lhr-solar/Active-Precharge-Board/SOT-89-3_2P7X4P7_ONS.step

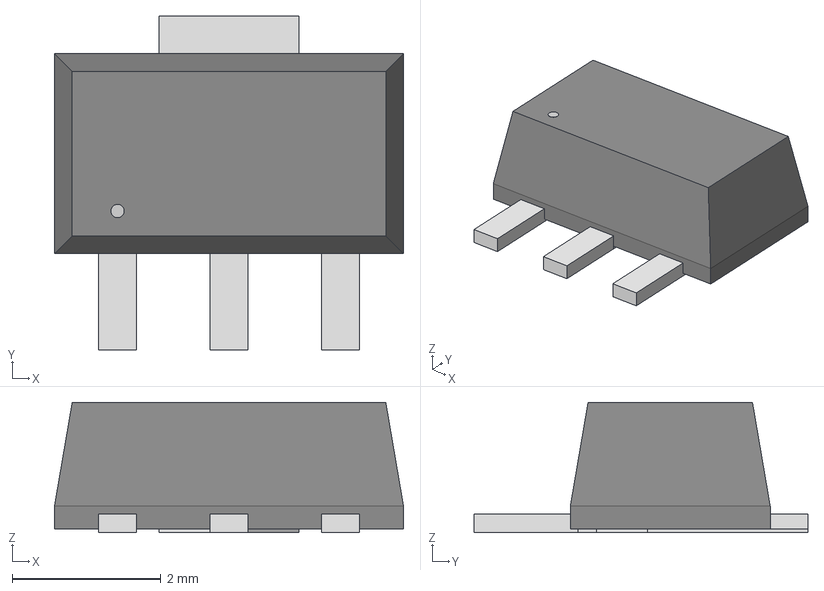
[picture p1: CAD file, 2024-10-26]
SOT-89-3_2P7X4P7_ONS.step
4.70 x 4.50 x 1.75 mm
