lhr-solar/Active-Precharge-Board/ActivePrechargeLib/ActivePrechargeLib3d/BZT52-B12-QX.stp

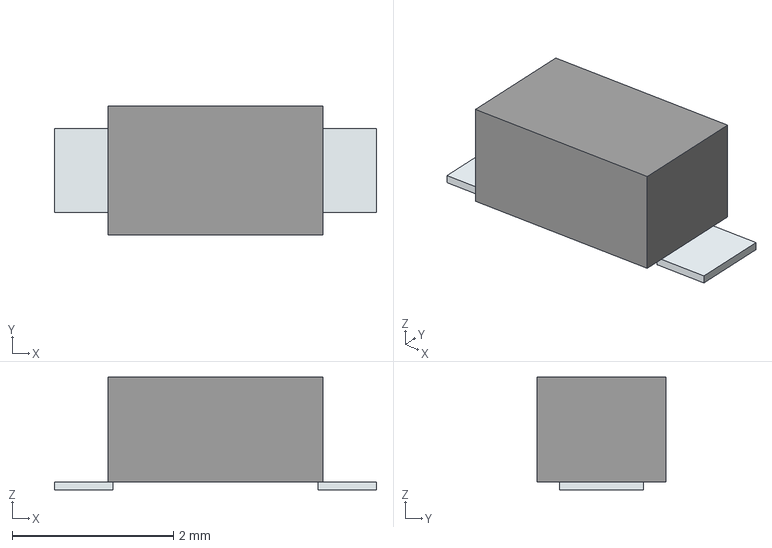
[picture p2: CAD file, 2025-01-31]
ActivePrechargeLib/ActivePrechargeLib3d/BZT52-B12-QX.stp
4.00 x 1.60 x 1.40 mm
Pins
