lhr-solar/Active-Precharge-Board/ActivePrechargeLib/ActivePrechargeLib3d/SSM3J374R,LF.stp

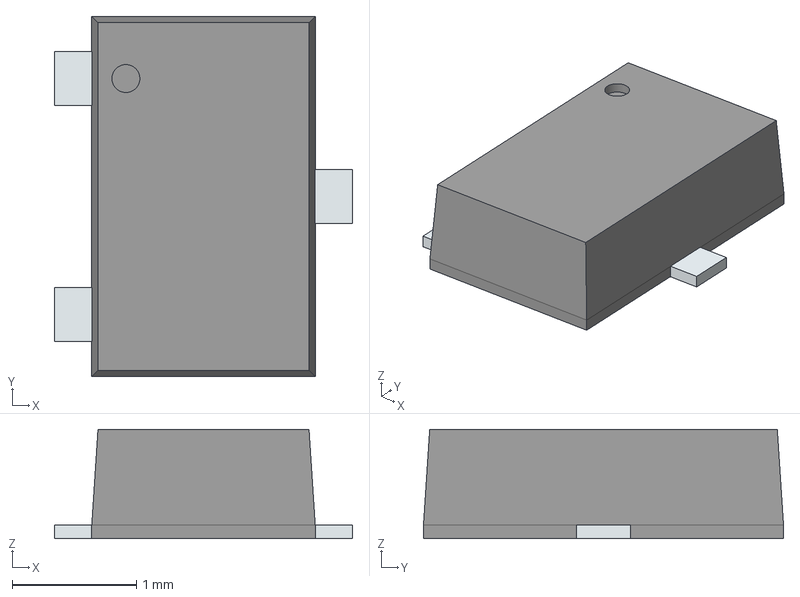
[picture p3: CAD file, 2025-01-31]
ActivePrechargeLib/ActivePrechargeLib3d/SSM3J374R,LF.stp
2.40 x 2.90 x 0.878 mm
PinsArrayL
PinsArrayR
