lhr-solar/Active-Precharge-Board/ActivePrechargeLib/ActivePrechargeLib3d/CMS08_TE12L,Q,M_.stp

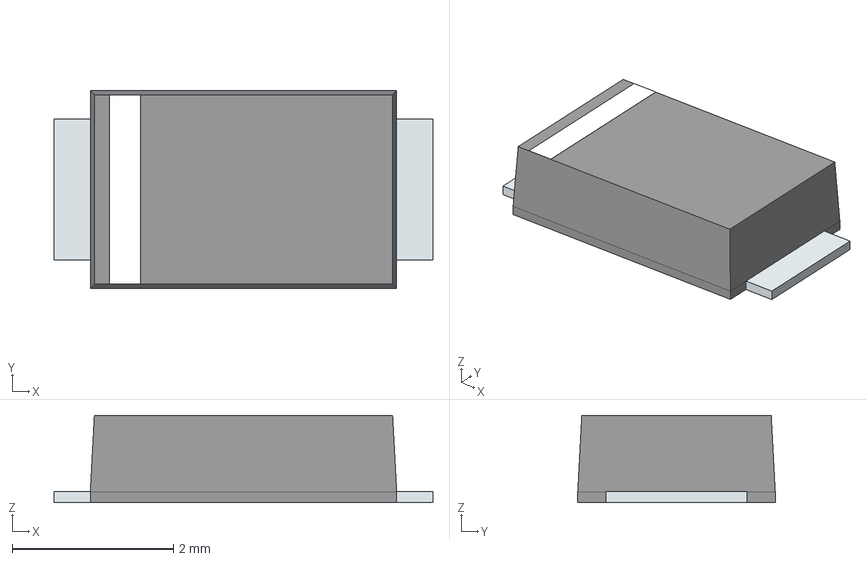
[picture p4: CAD file, 2024-10-30]
ActivePrechargeLib/ActivePrechargeLib3d/CMS08_TE12L,Q,M_.stp
4.70 x 2.45 x 1.08 mm
PinKIdent
PinK
PinA
