lhr-solar/Active-Precharge-Board/ActivePrechargeLib/ActivePrechargeLib3d/430450613.stp

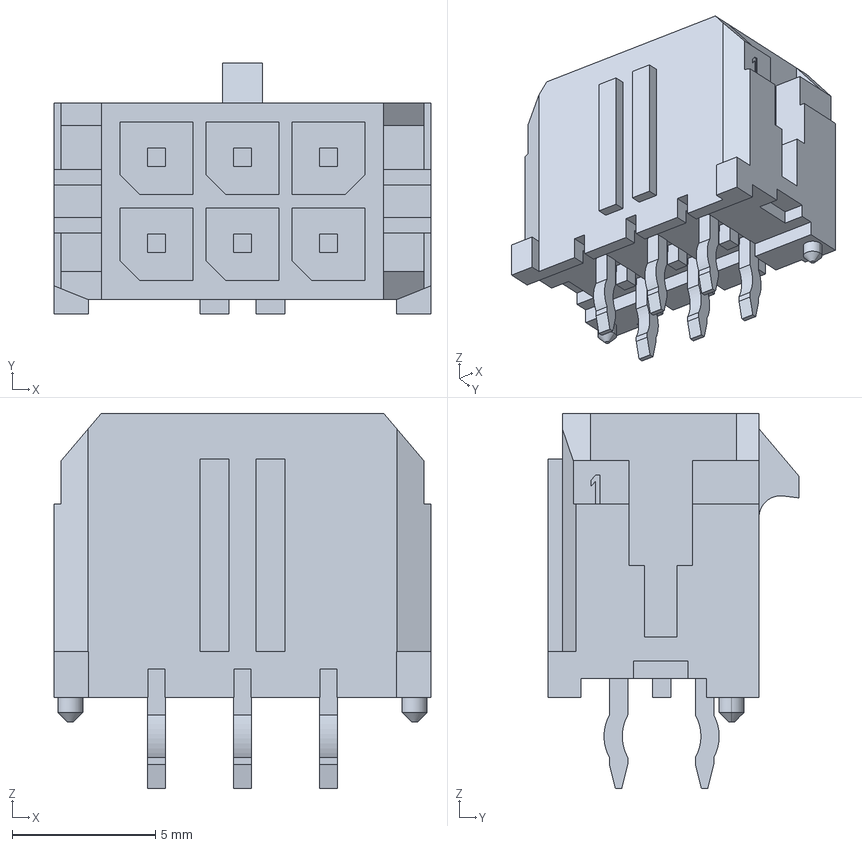
[picture p5: CAD file, 2025-01-31]
ActivePrechargeLib/ActivePrechargeLib3d/430450613.stp
13.2 x 8.77 x 13.1 mm
