lhr-solar/Active-Precharge-Board/ActivePrechargeLib/ActivePrechargeLib3d/1769205241.stp

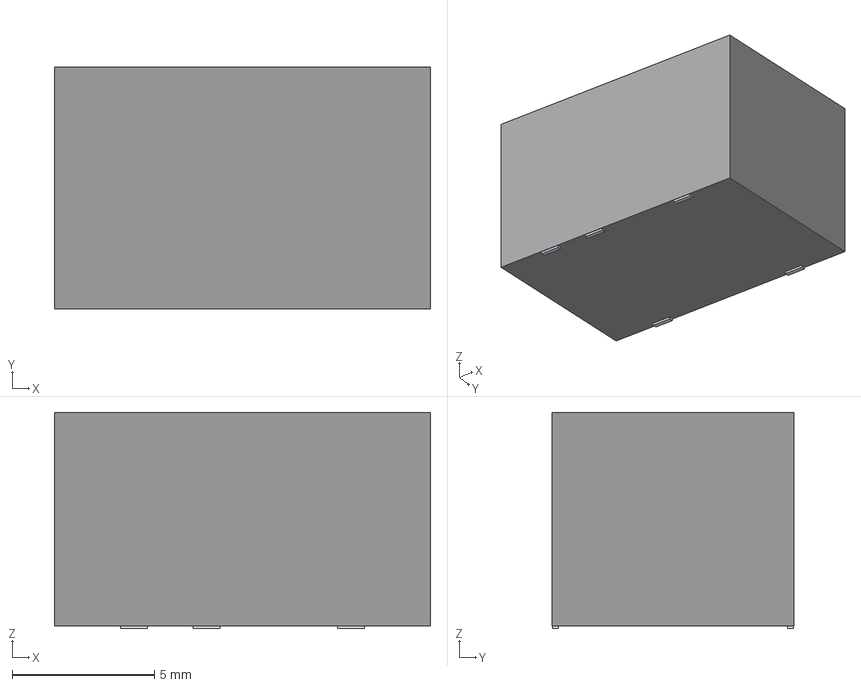
[picture p6: CAD file, 2025-01-31]
ActivePrechargeLib/ActivePrechargeLib3d/1769205241.stp
13.2 x 8.50 x 7.60 mm
Pins
