lhr-solar/Active-Precharge-Board/ActivePrechargeLib/ActivePrechargeLib3d/436500315.stp

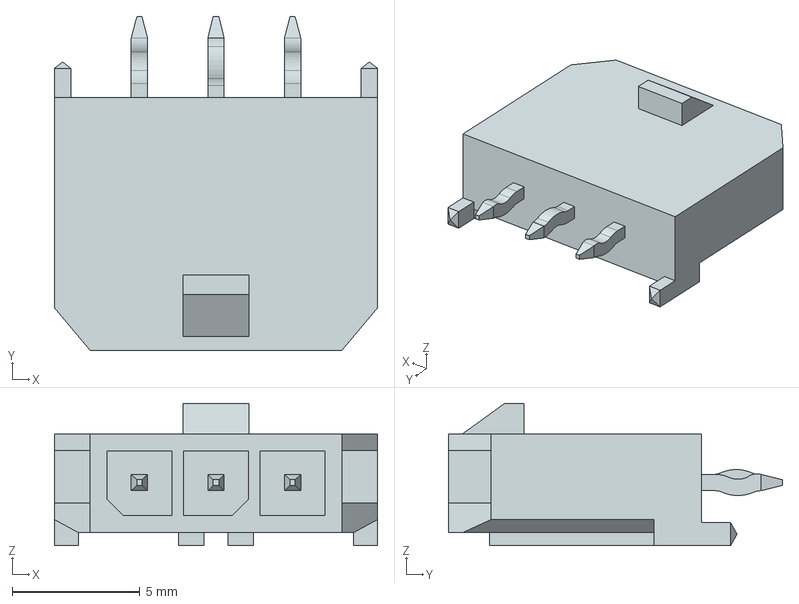
[picture p7: CAD file, 2025-01-31]
ActivePrechargeLib/ActivePrechargeLib3d/436500315.stp
12.7 x 13.1 x 5.57 mm
