lhr-solar/Active-Precharge-Board/ActivePrechargeLib/ActivePrechargeLib3d/46205000000.stp

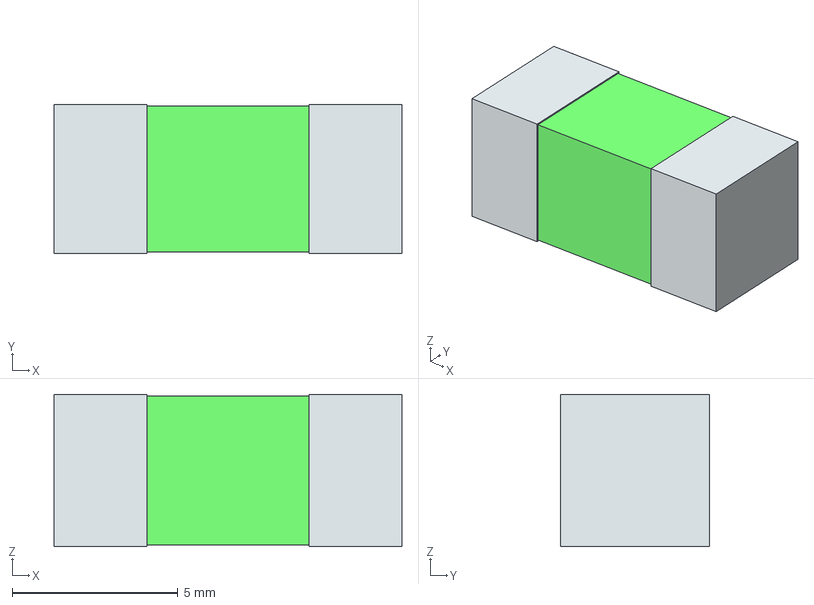
[picture p8: CAD file, 2024-10-26]
ActivePrechargeLib/ActivePrechargeLib3d/46205000000.stp
10.5 x 4.50 x 4.60 mm
term1
term2
