lhr-solar/Active-Precharge-Board/ActivePrechargeLib/ActivePrechargeLib3d/2220B225K251CT.stp

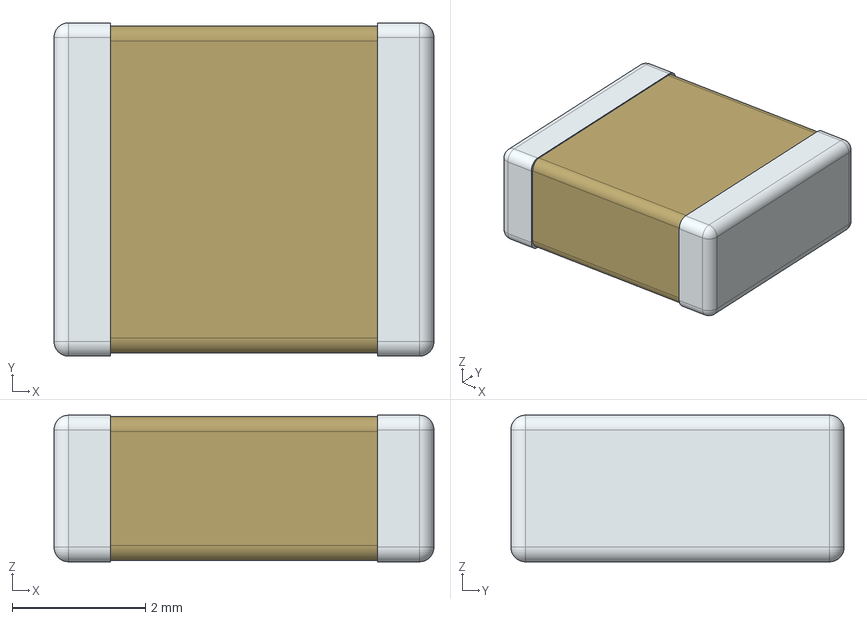
[picture p9: CAD file, 2024-10-26]
ActivePrechargeLib/ActivePrechargeLib3d/2220B225K251CT.stp
5.70 x 5.00 x 2.20 mm
