lhr-solar/Active-Precharge-Board/(list of files, cad)

Other CAD files:
ActivePrechargeLib/ActivePrechargeLib3d/SOT-89-3_2P7X4P7_ONS.step
