lhr-solar/Active-Precharge-Board/ActivePrecharge.kicad_pcb

## KiCad design ActivePrecharge.kicad_pcb (2025-01-31)

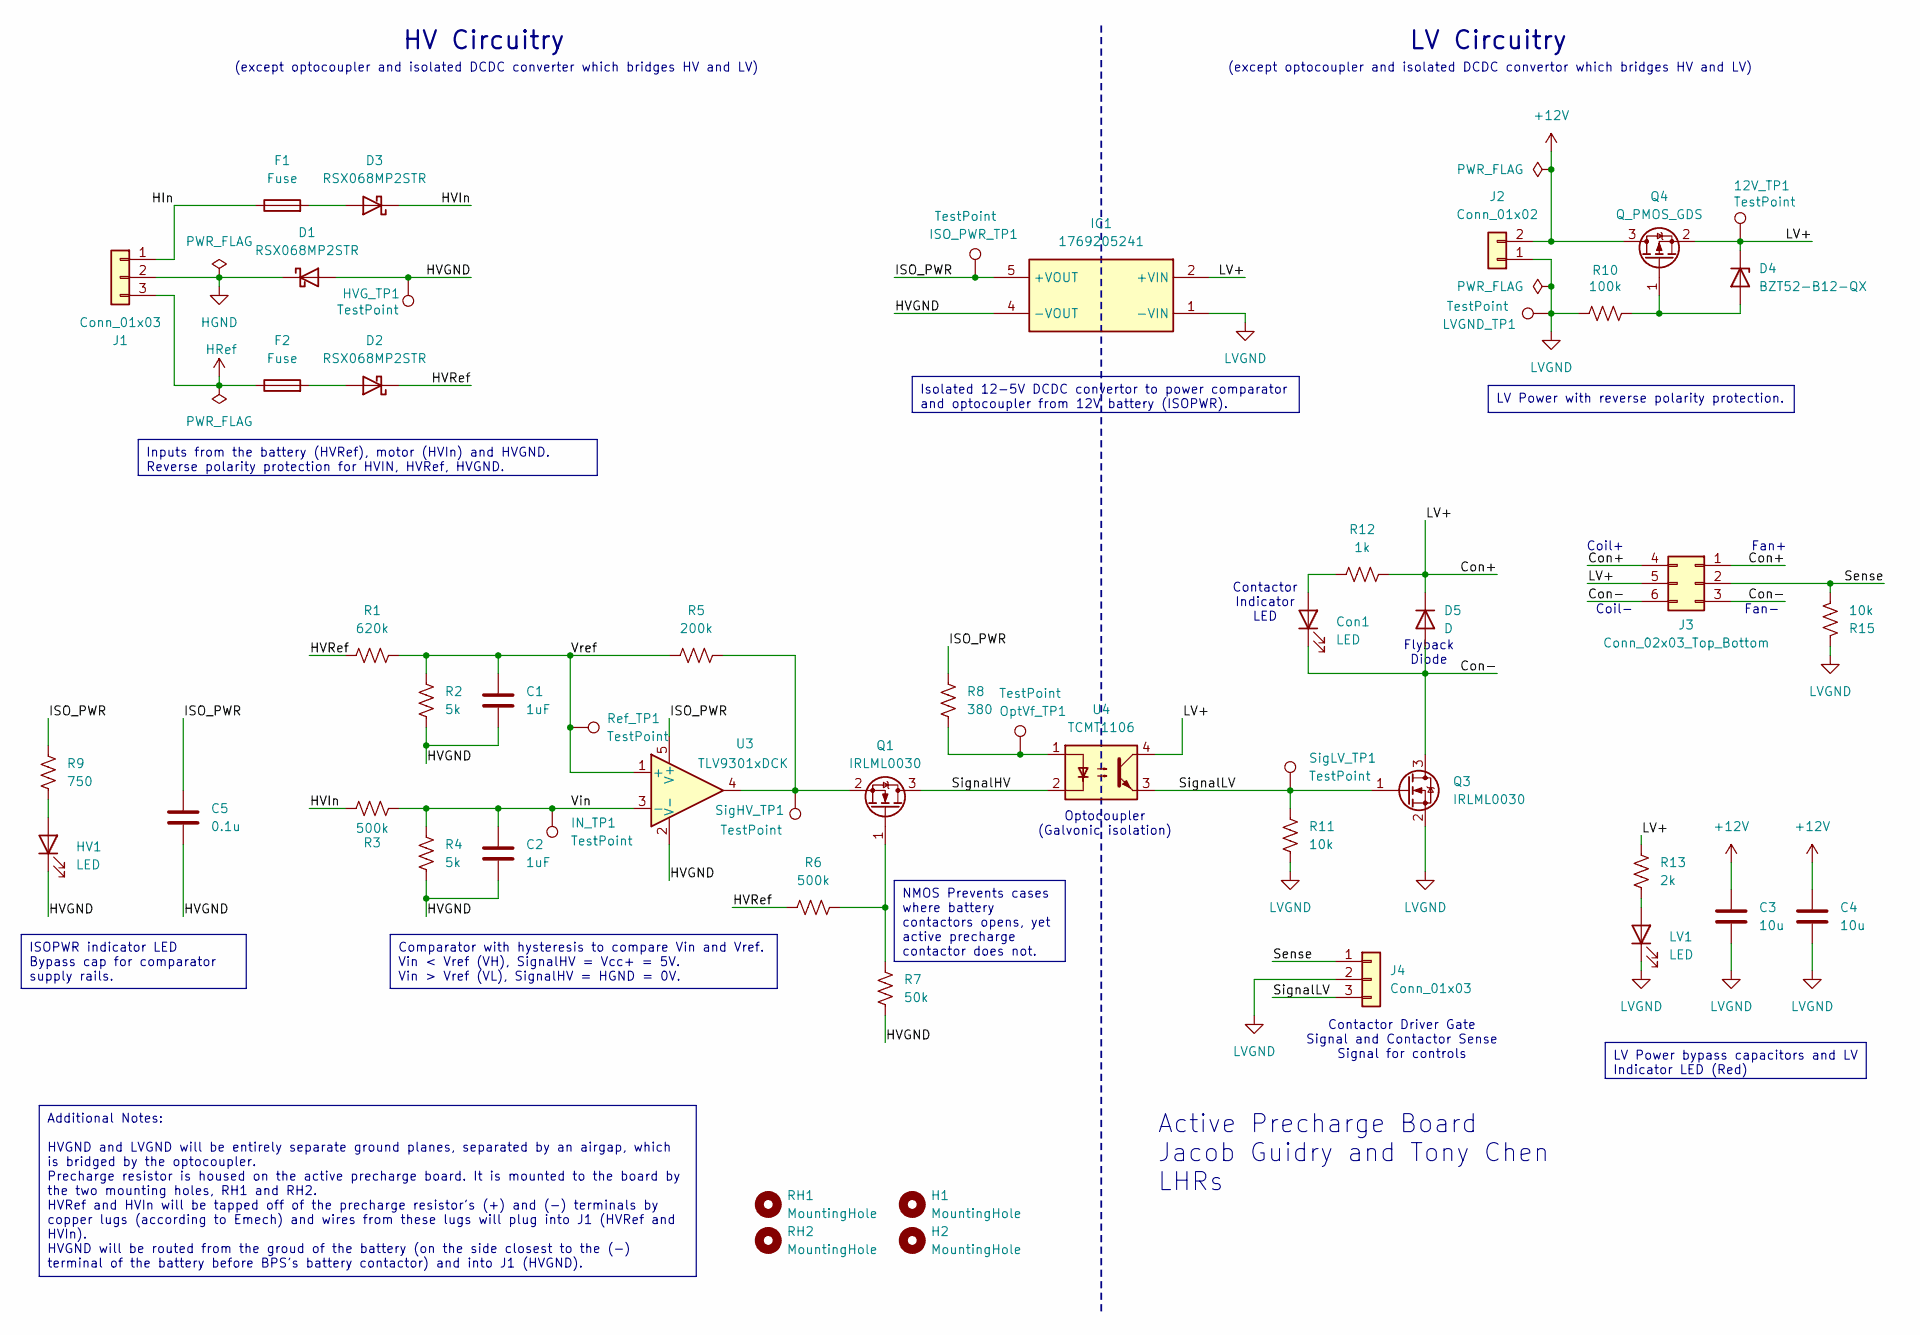
[picture p10: schematic ActivePrecharge.kicad_sch]

Parts:
12V_TP1: TestPoint; TestPoint_HEX_3mmID
C1, C2: 1uF; C_0805_2012Metric
C3, C4: 10u; C_0805_2012Metric
C5: 0.1u; C_0805_2012Metric
Con1: LED; LED_0805_2012Metric
D1, D2, D3: RSX068MP2STR; D_SOD-123F
D4: BZT52-B12-QX; BZT52B12QX
D5: D; SODFL4724X108N
F1, F2: Fuse; Fuseholder_Blade_Mini_Keystone_3568
H1, H2: MountingHole; MountingHole_3mm
HV1: LED; LED_0805_2012Metric
HVG_TP1: TestPoint; TestPoint_HEX_3mmID
IC1: 1769205241; Manufacturer_Part_Number 1769205241
IN_TP1: TestPoint; TestPoint_HEX_3mmID
ISO_PWR_TP1: TestPoint; TestPoint_HEX_3mmID
J1, J4: Conn_01x03; Molex_MicroFit3.0_1x3xP3.00mm_PolarizingPeg_Vertical
J2: Conn_01x02; Molex_MicroFit3.0_1x2xP3.00mm_PolarizingPeg_Vertical
J3: Conn_02x03_Top_Bottom; CONN_SD-43045-005_06_MOL
LV1: LED; LED_0805_2012Metric
LVGND_TP1: TestPoint; TestPoint_HEX_3mmID
OptVf_TP1: TestPoint; TestPoint_HEX_3mmID
Q1, Q3: IRLML0030; SOT-23
Q4: Q_PMOS_GDS; SOT-23-3
R1: 620k; R_1206_3216Metric
R2, R4: 5k; R_0805_2012Metric
R3, R6: 500k; R_1206_3216Metric
R5: 200k; R_0805_2012Metric
R7: 50k; R_0805_2012Metric
R8: 380; R_0805_2012Metric
R9: 750; R_0805_2012Metric
R10: 100k; R_0805_2012Metric
R11, R15: 10k; R_0805_2012Metric
R12: 1k; R_0805_2012Metric
R13: 2k; R_0805_2012Metric
RH1, RH2: MountingHole; MountingHole_3.2mm_M3
Ref_TP1: TestPoint; TestPoint_HEX_3mmID
SigHV_TP1: TestPoint; TestPoint_HEX_3mmID
SigLV_TP1: TestPoint; TestPoint_HEX_3mmID
U3: TLV9301xDCK; SOT-353_SC-70-5
U4: TCMT1106; SOP-4_4.4x2.6mm_P1.27mm

Connections:
+12V: C3.1, C4.1, J2.2, Q4.3 (S)
/Con+: 12V_TP1.1, D4.1 (K), D5.1 (K), IC1.2 (+VIN), J3.1, J3.4, J3.5, Q4.2 (D), R12.2, R13.1, U4.4
/Con-: Con1.1 (K), D5.2 (A), J3.3, J3.6, Q3.3 (D)
/HIn: F1.1, J1.1
/HVGND: C1.2, C2.2, C5.2, D1.2 (A), HV1.1 (K), HVG_TP1.1, IC1.4 (-VOUT), R2.2, R4.2, R7.1, U3.2 (V-)
/HVIn: D3.1 (K), R3.2
/HVRef: D2.1 (K), R1.1, R6.1
/ISO_PWR: C5.1, IC1.5 (+VOUT), ISO_PWR_TP1.1, R8.2, R9.1, U3.5 (V+)
/Sense: J3.2, J4.1, R15.2
/SignalHV: Q1.3 (D), U4.2
/SignalLV: J4.3, Q3.1 (G), R11.1, SigLV_TP1.1, U4.3
/Vin: C2.1, IN_TP1.1, R3.1, R4.1, U3.3 (-)
/Vref: C1.1, R1.2, R2.1, R5.2, Ref_TP1.1, U3.1 (+)
HGND: D1.1 (K), J1.2
HRef: F2.1, J1.3
LVGND: C3.2, C4.2, IC1.1 (-VIN), J2.1, J4.2, LV1.1 (K), LVGND_TP1.1, Q3.2 (S), R10.1, R11.2, R15.1
unnamed: Con1.2 (A), R12.1
unnamed: D2.2 (A), F2.2
unnamed: D3.2 (A), F1.2
unnamed: D4.2 (A), Q4.1 (G), R10.2
unnamed: HV1.2 (A), R9.2
unnamed: LV1.2 (A), R13.2
unnamed: OptVf_TP1.1, R8.1, U4.1
unnamed: Q1.1 (G), R6.2, R7.2
unnamed: Q1.2 (S), R5.1, SigHV_TP1.1, U3.4

Notes on the sheet:
ISOPWR indicator LED Bypass cap for comparator supply rails.
NMOS Prevents cases where battery contactors opens, yet active precharge contactor does not.
Inputs from the battery (HVRef), motor (HVIn) and HVGND. Reverse polarity protection for HVIN, HVRef, HVGND.
Comparator with hysteresis to compare Vin and Vref. Vin < Vref (VH), SignalHV = Vcc+ = 5V. Vin > Vref (VL), SignalHV = HGND = 0V.
LV Power with reverse polarity protection.
LV Power bypass capacitors and LV Indicator LED (Red)
Additional Notes: HVGND and LVGND will be entirely separate ground planes, separated by an airgap, which is bridged by the optocoupler. Precharge resistor is housed on the active precharge board. It is mounted to the board by the two mounting holes, RH1 and RH2. HVRef and HVIn will be tapped off of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
Isolated 12-5V DCDC convertor to power comparator and optocoupler from 12V battery (ISOPWR).
Coil+
Contactor Driver Gate Signal and Contactor Sense Signal for controls
LV Circuitry
Fan+
Flyback Diode
HV Circuitry
Optocoupler (Galvonic isolation)
(except optocoupler and isolated DCDC converter which bridges HV and LV)
Coil-
Contactor Indicator LED
Fan-
(except optocoupler and isolated DCDC convertor which bridges HV and LV)
Active Precharge Board Jacob Guidry and Tony Chen LHRs

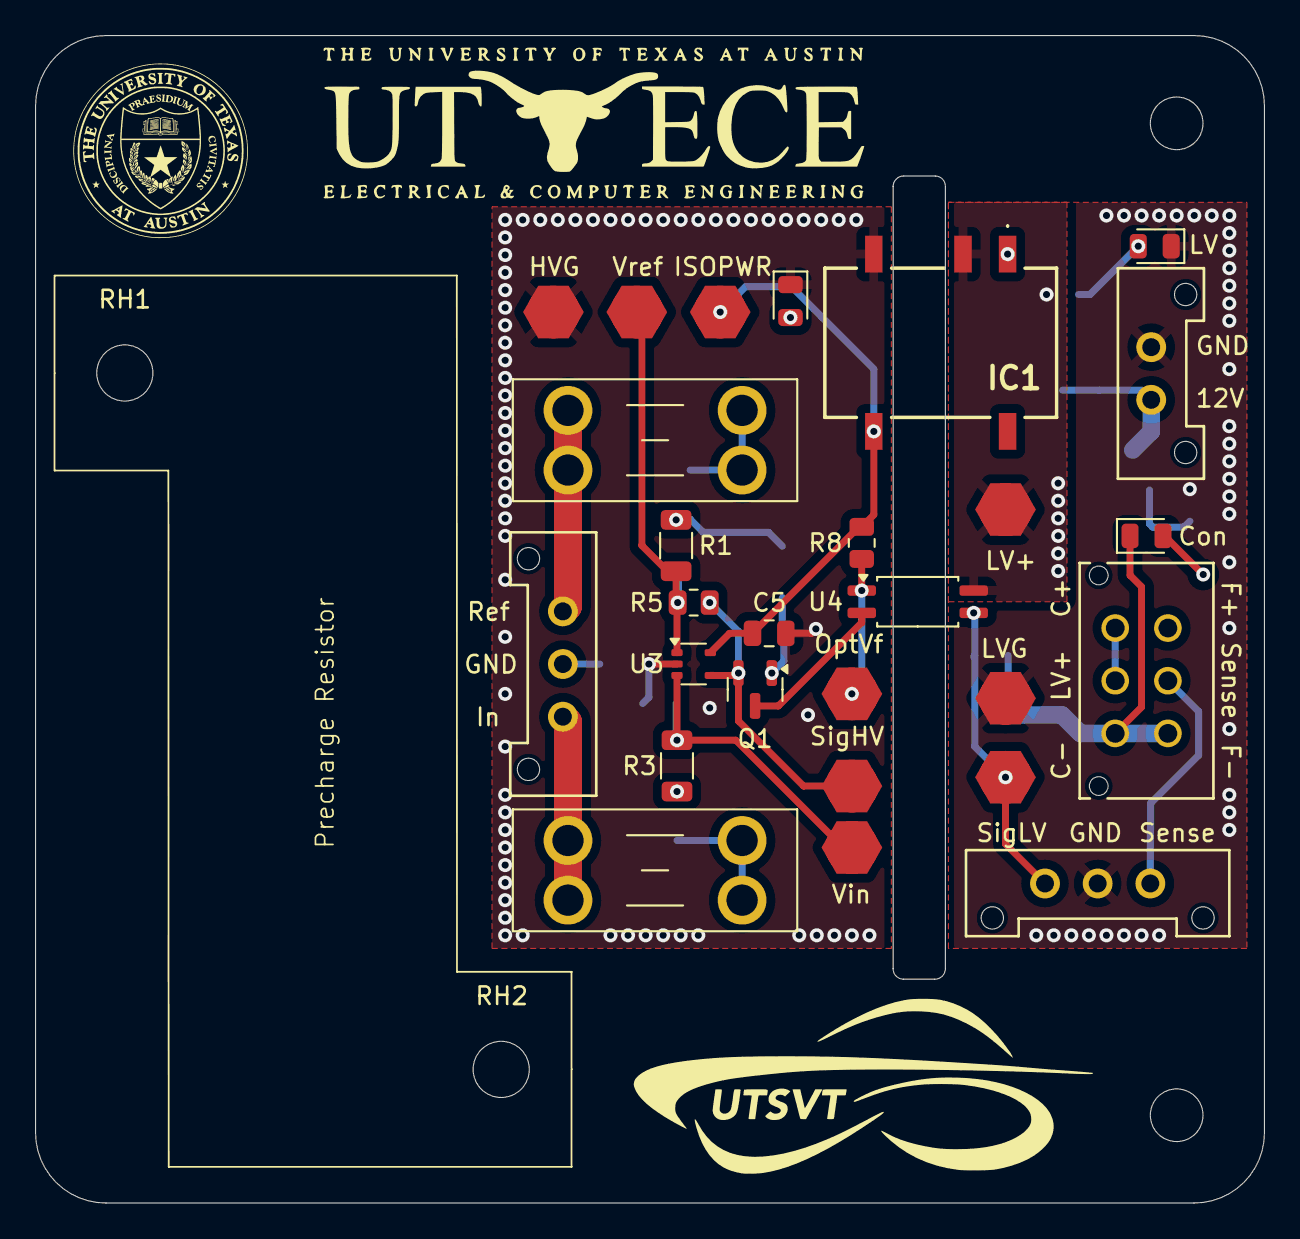
[picture p11: board ActivePrecharge.kicad_pcb from above]

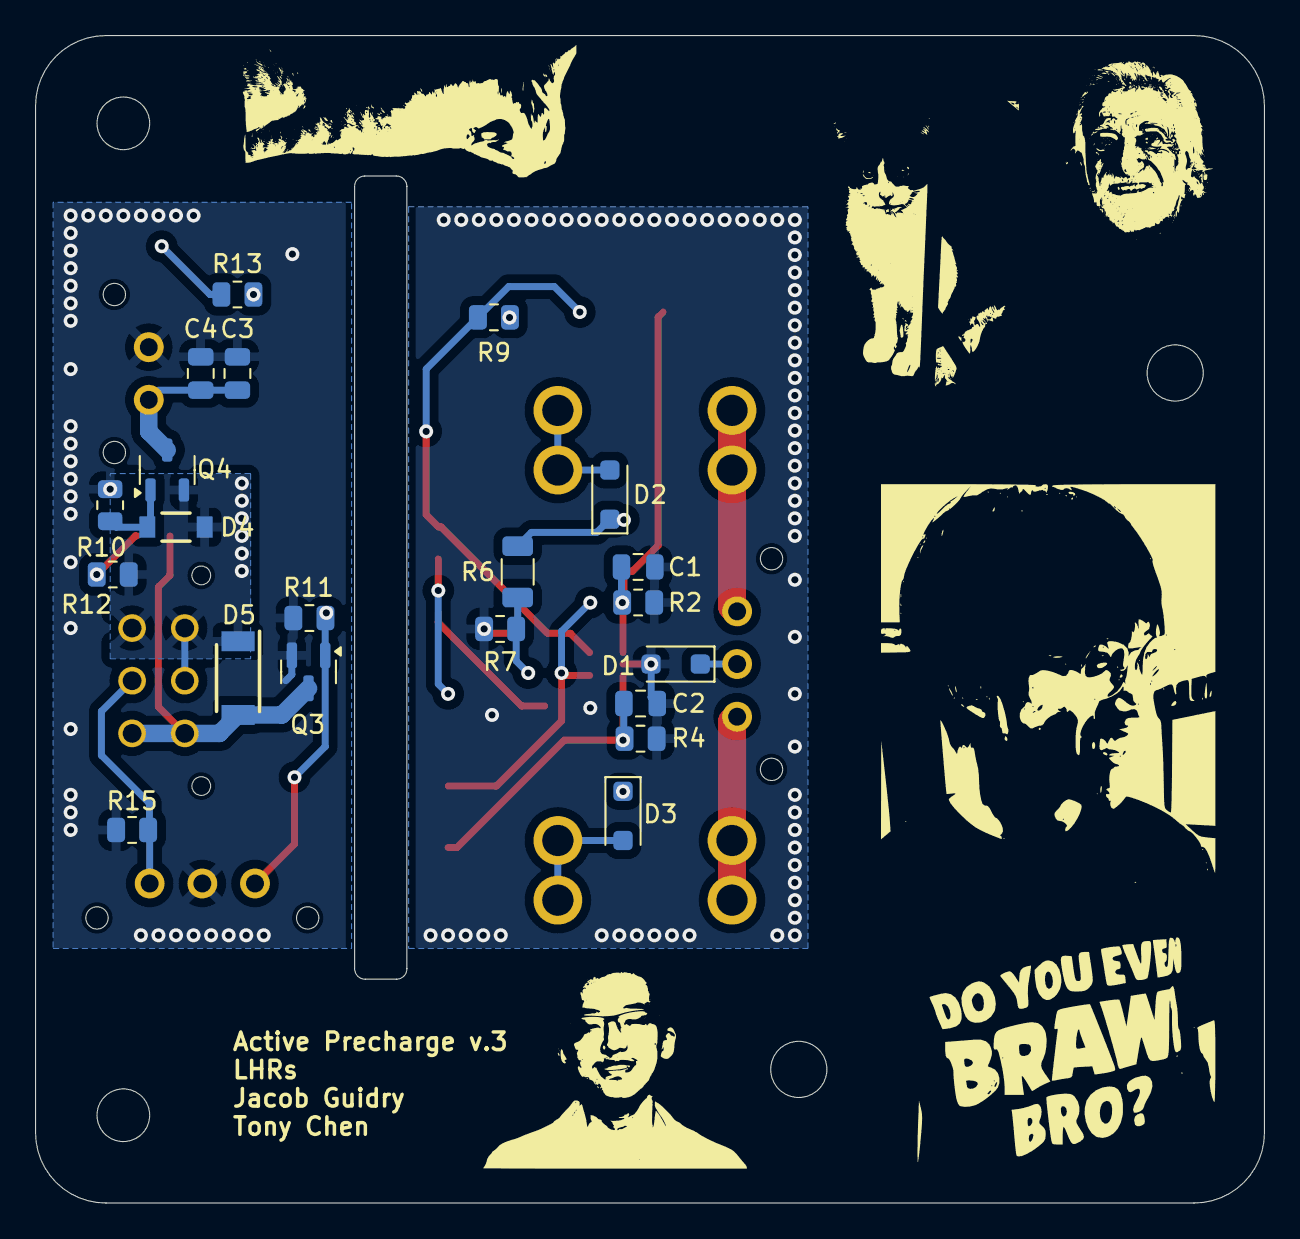
[picture p12: board ActivePrecharge.kicad_pcb from below]

Board: 2 copper layers, 70.0 x 66.5 mm, 52 parts (21 on the bottom side), 25 nets.
