lhr-solar/Active-Precharge-Board/Firmware/Drivers/Inc/StatusLEDs.h

#ifndef STATUSLEDS_H
#define STATUSLEDS_H

#include "stm32xx_hal.h"

/**
 * Possible Status LED Pins
 */
typedef enum {
    MOTOR_SENSE_FAULT_LED = 0,
    MOTOR_TIMEOUT_FAULT_LED,
    ARRAY_SENSE_FAULT_LED,
    ARRAY_TIMEOUT_FAULT_LED,
    ONBOARD_LED,
    NUM_STATUS_LED,
} status_led_t;

// Status LEDs
#define MOTOR_TIMEOUT_FAULT_LED_PORT GPIOA
#define MOTOR_TIMEOUT_FAULT_LED_PIN GPIO_PIN_10

#define MOTOR_SENSE_FAULT_LED_PORT GPIOA
#define MOTOR_SENSE_FAULT_LED_PIN GPIO_PIN_8

#define ARRAY_TIMEOUT_FAULT_LED_PORT GPIOB
#define ARRAY_TIMEOUT_FAULT_LED_PIN GPIO_PIN_3

#define ARRAY_SENSE_FAULT_LED_PORT GPIOA
#define ARRAY_SENSE_FAULT_LED_PIN GPIO_PIN_9

#define ONBOARD_LED_PORT GPIOB
#define ONBOARD_LED_PIN GPIO_PIN_3

/**
* @brief Initializes Status LED pins
*
*/
void Status_Leds_Init(void);

/**
 * @brief   Writes data to a specified pin
 * @param   led The led to write to
 * @param   state true=ON or false=OFF
 * @return  None
 */
void Status_Leds_Write(status_led_t led, bool state);

/**
 * @brief   Toggles a status led
 * @param   led The led to toggle
 * @return  None
 */
void Status_Leds_Toggle(status_led_t led);

/**
 * @brief   Turns all status LEDs on
 * @return  None
 */
void Status_Leds_All_On(void);

#endif
