lhr-solar/Active-Precharge-Board/(commit log)

2024-10-19 add kicadlibraries
2024-10-19 Jacob ActivePrecharge footprints completed and layout started
    [ActivePrecharge.kicad_pcb, ActivePrecharge.kicad_sch]
2024-10-26 end of workday 10/26/2024
    [ActivePrecharge.kicad_pcb, ActivePrecharge.kicad_sch]
2024-10-26 with new component footprints and cad files
    [2220B225K251CT.SchLib, 2220B225K251CT.stp, 46205000000.stp, CAPC5750X220N.PcbLib, EDI2CAP.CFG, SOT-89-3_2P7X4P7_ONS.step, capc5750x220n.psm, chips.prt]
2024-10-30 sch ready for review, project specific footprint and 3d model libraries created
    [2220B225K251CT.SchLib, 2220B225K251CT.stp, 46205000000.stp, ActivePrecharge.kicad_pcb, ActivePrecharge.kicad_sch, CAPC5750X220N.PcbLib, CMS08_TE12L,Q,M_.stp, EDI2CAP.CFG]
2024-10-31 selected LV bypass caps values
    [ActivePrecharge.kicad_pcb, ActivePrecharge.kicad_sch]
2024-10-31 finalized layout, fixed prechagre res dimensions
    [ActivePrecharge.kicad_pcb, ActivePrecharge.kicad_sch]
2024-11-01 removed LDO fuse, added series resistors, added to sch explinations, changed layout accordingly, sch and layout ready for review
    [ActivePrecharge.kicad_sch]
2024-11-01 oops forgot to save last time, attempt two
    [ActivePrecharge.kicad_pcb, ActivePrecharge.kicad_sch]
2024-11-02 added silkscreen title
    [ActivePrecharge.kicad_pcb]
2024-11-02 passes ERC now, added dimensions on layout editor
    [ActivePrecharge.kicad_pcb, ActivePrecharge.kicad_sch]
2024-11-02 fixed optocoupler data sheet link
    [ActivePrecharge.kicad_sch]
2024-11-02 added connector labels
    [ActivePrecharge.kicad_pcb]
2024-11-02 11/2 fixed incorrect footprint and symbol
    [ActivePrecharge.kicad_pcb, ActivePrecharge.kicad_sch]
2024-11-02 HV and trace routing fixes
    [ActivePrecharge.kicad_pcb]
2024-11-02 dimension checks and silkscreen additions
    [ActivePrecharge.kicad_pcb]
2024-11-02 revert LDO HV resistor position
    [ActivePrecharge.kicad_pcb]
2024-11-02 adjusted HVGND position to be more centralized, added backplane traces and vias to route HVGND up to somewhat isolated top region, routed R1, R3 top plane traces on the back
    [ActivePrecharge.kicad_pcb, ActivePrecharge.kicad_sch]
2024-11-02 refix HVGND isolation issue
    [ActivePrecharge.kicad_pcb]
2024-11-02 fixed positioning of silkscreen labels for HV 1x3 connector
    [ActivePrecharge.kicad_pcb]
2024-11-02 fixed silkscreen and edge cuts issues
    [ActivePrecharge.kicad_pcb]
2024-11-06 initial sch and layout changes w/ test points
    [ActivePrecharge.kicad_pcb, ActivePrecharge.kicad_sch]
2024-11-06 finished layout w/ all testpoints
    [ActivePrecharge.kicad_pcb]
2024-11-06 improved tp labels, moved vias on the tp rather than next to the tp, removed ConIndVf and LVIndVf tp (pointless)
    [ActivePrecharge.kicad_pcb, ActivePrecharge.kicad_sch]
2024-11-10 redid sch and layout w/ reverse polarity protection on HV and LV inputs, low pass filter on comparator inputs, hystersesis on comparator
    [ActivePrecharge.kicad_pcb, ActivePrecharge.kicad_sch, BZT52-B12-QX.stp, untitled.kicad_sch]
2024-11-10 try 2
    [ActivePrecharge.kicad_pcb]
2024-11-10 updated sch explinations with new additions from today's workday
    [ActivePrecharge.kicad_sch]
2024-11-10 fixed pmos orientation on LV reverse polarity protection, was s and d were backwards
    [ActivePrecharge.kicad_pcb, ActivePrecharge.kicad_sch]
2024-11-11 HV Layout w/ components on the back
    [ActivePrecharge.kicad_pcb, ActivePrecharge.kicad_sch]
2024-11-13 components places on both sides of the board for HV and LV sides, ready for review
    [ActivePrecharge.kicad_pcb, ActivePrecharge.kicad_sch]
2024-11-16 sch done for workday 11/16/2024
    [1769205241.stp, ActivePrecharge.kicad_pcb, ActivePrecharge.kicad_sch, SSM3J374R,LF.stp]
2024-11-19 layout and sch ready for review (isolated DCDC convertor version)
    [ActivePrecharge.kicad_pcb, ActivePrecharge.kicad_sch]
2024-11-19 added silkscreen labels to HV 1x3 connector
    [436500315.stp, ActivePrecharge.kicad_pcb]
2024-11-23 finished for review
    [ActivePrecharge.kicad_pcb, ActivePrecharge.kicad_sch]
2024-11-23 fixed incorrect pmos pinout
    [ActivePrecharge.kicad_pcb, ActivePrecharge.kicad_sch]
2024-12-06 pretty sch changxu approved
    [ActivePrecharge-B_Cu.gbl, ActivePrecharge-B_Mask.gbs, ActivePrecharge-B_Paste.gbp, ActivePrecharge-B_Silkscreen.gbo, ActivePrecharge-Edge_Cuts.gm1, ActivePrecharge-F_Cu.gtl, ActivePrecharge-F_Mask.gts, ActivePrecharge-F_Paste.gtp]
2024-12-14 started hv layout rework w/ fuses, changed lv layout connectors
    [ActivePrecharge.kicad_pcb, ActivePrecharge.kicad_sch]
2024-12-26 all layout and sch changes finished, ready for frank to review
    [430450613.stp, ActivePrecharge.kicad_pcb, ActivePrecharge.kicad_sch]
2024-12-29 pushing new changes 12/29
    [ActivePrecharge.kicad_pcb]
2024-12-31 ready for order from jlc
    [ActivePrecharge.kicad_pcb]
2024-12-31 oops didnt save
    [ActivePrecharge.kicad_pcb]
2025-01-06 v.3 ordered, fixed lv reverse polarity pmos body diode
    [ActivePrecharge-B_Cu.gbl, ActivePrecharge-B_Mask.gbs, ActivePrecharge-B_Paste.gbp, ActivePrecharge-B_Silkscreen.gbo, ActivePrecharge-Edge_Cuts.gm1, ActivePrecharge-F_Cu.gtl, ActivePrecharge-F_Mask.gts, ActivePrecharge-F_Paste.gtp]
2025-01-17 friday meeting for tony
    [ActivePrecharge.kicad_pcb, ActivePrecharge.kicad_sch]
2025-02-22 rm gerbers again
    [ActivePrecharge-B_Cu.gbl, ActivePrecharge-B_Mask.gbs, ActivePrecharge-B_Paste.gbp, ActivePrecharge-B_Silkscreen.gbo, ActivePrecharge-Edge_Cuts.gm1, ActivePrecharge-F_Cu.gtl, ActivePrecharge-F_Mask.gts, ActivePrecharge-F_Paste.gtp]
2025-08-15 MVP contactor board firmware (#9)
    * delete useless files
    * file structure, CAN/statusLED drivers, init task, tests
    * start contactors driver, CAN metadata
    * new enum, struct, function headers
    * setContactor
    * contactors init/get
    * contactors_set and precharge fault handling
    * dumb
    * erm
    * lakslay
    * blah blah
    * more faults
    * ign state
    * fawlt
    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
    [CANMetaData.h, CANbus.c, ContactorTask.c, ContactorTask.h, Contactors.c, Contactors.h, InitTask.c]
